j-wut/gp2040-hardware/README.md

# Open Stick Community hardware repo

This repository is a collection of open-source hardware designs which have been submitted to the project.

# Designs

3D Prints

- [3D Printable Stand - Small](/3D%20Prints/3D%20Printable%20Stand/README.md) - Designed by TheTrain
- [3D Printable Stand - Large](/3D%20Prints/3D%20Printable%20Stand/README.md) - Designed by TheTrain
- [3D Printable Fightstick Case](/3D%20Prints/Fightstick%20Case/README.md) - Designed by TheTrain
- [3D Printable Open Stick Mini](/3D%20Prints/Open%20Stick%20Mini/README.md) - Designed by TheTrain
- [3D Printable Fightstick Case XL](/3D%20Prints/Fightstick%20Case/Community%20submissions/3D%20print%20files/Fightstick%20XL/Open%20Stick%20XL%20-%20Main%20Frame%20(x4%20Buttons).stl) - Designed by Lucipher
- [3D Printable Open Stick Modular](/3D%20Prints/Open%20Stick%20Modular%20(OSM)/README.md) - Designed by TheTrain
- [3D Printable Open Stick Modular - Mini](/3D%20Prints/Open%20Stick%20Modular%20-%20Mini%20(OSM-Mini)/README.md) - Designed by TheTrain
- [3D Printable Open Stick Modular - Slim](/3D%20Prints/Open%20Stick%20Modular%20-%20Slim%20(OSM-Slim)/README.md) - Designed by TheTrain
- [3D Printable Open Stick Astro](/3D%20Prints/Open%20Stick%20Astro%20(OSASTRO)/README.md) - Designed by TheTrain
- [3D Printable OSBMX v2 Buttons](/3D%20Prints/OSBMX%20v2/README.md) - Designed by TheTrain
- [3D Printable OSBLP v2 Buttons](/3D%20Prints/OSBLP%20v2/README.md) - Designed by TheTrain
- [3D Printable OSBMX v2 SiTong Edition Buttons](/3D%20Prints/OSBMX%20v2/Community%20submissions/OSBMX%20v2%20-%20SiTong%20Edition/README.md) - Designed by TheTrain (remixed from the OSBLP v2 by TheTrain)
- [3D Printable OSBLP v2 SiTong Edition Buttons](/3D%20Prints/OSBLP%20v2/Community%20submissions/OSBLP%20v2%20-%20SiTong%20Edition/README.md) - Designed by TheTrain (remixed from the OSBLP v2 by TheTrain)
- [3D Printable OSBHE v2 Buttons](/3D%20Prints/OSBHE%20v2/README.md) - Designed by TheTrain
- [3D Printable OSB Plug](/3D%20Prints/OSB%20Plug/README.md) - Designed by TheTrain
- [3D Printable OSB Analog Stick](/3D%20Prints/OSB%20Analog%20Stick/README.md) - Designed by TheTrain
- [Open Source Arcade Stand - OSAS](/3D%20Prints/Open%20Source%20Arcade%20Stand%20(OSAS)/README.md) - Designed by TheTrain

GP2040-CE Official Boards

- [RP2040 Advanced Breakout Board v5.6E with USB Passthrough](/Boards/GP2040-CE%20Official%20Boards/RP2040%20Advanced%20Breakout%20Board/RP2040%20Advanced%20Breakout%20Board%20-%20Passthrough/README.md) - Designed by TheTrain
- [RP2040 Advanced Breakout Board v5.2E (no USB Passthrough)](/Boards/GP2040-CE%20Official%20Boards/RP2040%20Advanced%20Breakout%20Board/RP2040%20Advanced%20Breakout%20Board/README.md) - Designed by TheTrain
- [RP2040 Basic Breakout Board v5.4E with USB Passthrough](/Boards/GP2040-CE%20Official%20Boards/RP2040%20Basic%20Breakout%20Board/RP2040%20Basic%20Breakout%20Board%20-%20Passthrough/README.md) - Designed by TheTrain
- [RP2040 Basic Breakout Board v5.4E (no USB Passthrough)](/Boards/GP2040-CE%20Official%20Boards/RP2040%20Basic%20Breakout%20Board/RP2040%20Basic%20Breakout%20Board/README.md) - Designed by TheTrain
- [RP2040 Mini Breakout Board v7.5E with USB Passthrough](/Boards/GP2040-CE%20Official%20Boards/RP2040%20Mini%20Breakout%20Board/RP2040%20Mini%20Breakout%20Board%20-%20Passthrough/README.md) - Designed by TheTrain
- [RP2040 Mini Breakout Board v7.3E (no USB Passthrough)](/Boards/GP2040-CE%20Official%20Boards/RP2040%20Mini%20Breakout%20Board/RP2040%20Mini%20Breakout%20Board/README.md) - Designed by TheTrain
- [RP2040 Quick Solder Breakout Board v1.0 (no USB Passthrough)](/Boards/GP2040-CE%20Official%20Boards/RP2040%20Quick%20Solder%20Breakout%20Board/README.md) - Designed by TheTrain

GP2040-CE Official Controllers

- [ARC Accessibility Controller](/Boards/GP2040-CE%20Official%20Controllers/ARC%20Accessibility%20Controller/README.md) - Designed by TheTrain
- [Flatbox Rev 5 RGB](/Boards/GP2040-CE%20Official%20Controllers/Flatbox%20Rev%205%20RGB/README.md) - Remixed by TheTrain from the Flatbox Rev 5 by Jfedor
- [Flatbox Rev 5 Passthrough](/Boards/GP2040-CE%20Official%20Controllers/Flatbox%20Rev%205%20Passthrough/README.md) - Remixed by TheTrain from the Flatbox Rev 5 by Jfedor
- [Open_Core0 v2.0](/Boards/GP2040-CE%20Official%20Controllers/Open_Core0/README.md) - Designed by TheTrain
- [Open_Core0 WASD v2.0](/Boards/GP2040-CE%20Official%20Controllers/Open_Core0%20WASD/README.md) - Designed by TheTrain
- [Open_Core0 MIXUP](/Boards/GP2040-CE%20Official%20Controllers/Open_Core0%20MIXUP/README.md) - Designed by TheTrain
- [Zero_Rhythm v1.0](/Boards/GP2040-CE%20Official%20Controllers/Zero%20Rhythm/README.md) - Designed by TheTrain
- [Pocket Pad](/Boards/GP2040-CE%20Official%20Controllers/Pocket%20Pad/README.md) - Designed by TheTrain
- [Pocket Pad WASD](/Boards/GP2040-CE%20Official%20Controllers/Pocket%20Pad%20WASD/README.md) - Designed by TheTrain
- [Mini Pad](/Boards/GP2040-CE%20Official%20Controllers/Mini%20Pad/README.md) - Designed by TheTrain

Retail Stick Replacement Boards

- [Hori Fighting Edge PS3 (FE PS3)](/Boards/Retail%20Stick%20Replacement%20Boards/Hori%20Fighting%20Edge%20PS3%20(FE%20PS3)/README.md) - Designed by TheTrain
- [Hori Fighting Edge PS4 (FE PS4)](/Boards/Retail%20Stick%20Replacement%20Boards/Hori%20Fighting%20Edge%20PS4%20(FE%20PS4)/README.md) - Designed by TheTrain
- [Hori Real Arcade Pro N PS4 (RAP N PS4)](/Boards/Retail%20Stick%20Replacement%20Boards/Hori%20Real%20Arcade%20Pro%20N%20PS4%20(RAP%20N%20PS4)/README.md) - Designed by TheTrain
- [Hori Real Arcade Pro VLX PS3 (RAP VLX PS3)](/Boards/Retail%20Stick%20Replacement%20Boards/Hori%20Real%20Arcade%20Pro%20VLX%20PS3%20(RAP%20VLX%20PS3)/README.md) - Designed by TheTrain
- [SEGA Dreamcast Twin Stick (with USB Passthrough)](/Boards/Retail%20Stick%20Replacement%20Boards/SEGA%20Dreamcast%20Twin%20Stick%20(with%20USB%20Passthrough)/README.md) - Designed by indigotrance

Supported Boards

- [Ghost Auth v2.0](/Boards/Supported%20Boards/Ghost%20Auth/README.md) - Designed by TheTrain
- [GP2040 Keyboard converter](/Boards/Supported%20Boards/GP2040%20Keyboard%20Converter/Waveshare%20Zero-PCB/README.md) - Designed by Infraredaces
- [USB Pasthrough Add-on Board](/Boards/Supported%20Boards/USB%20Passthrough%20Board/README.md) - Designed by TheTrain
- [Tiny USB Hub v1.2 - 2x USB with USB C](/Boards/Supported%20Boards/USB%20Hubs/Tiny%20USB%20Hub%20v1.2e/README.md) - Designed by TheTrain
- [Tiny USB Hub v1.3 - 2x USB Direct Connect](/Boards/Supported%20Boards/USB%20Hubs/Tiny%20USB%20Hub%20v1.3e/README.md) - Designed by TheTrain
- [Tiny USB Hub v1.3 v2 - 2x USB Direct Connect](/Boards/Supported%20Boards/USB%20Hubs/Tiny%20USB%20Hub%20v1.3e%20v2/README.md) - Designed by TheTrain
- [Tiny USB Hub v1.4 - 4x USB Direct Connect](/Boards/Supported%20Boards/USB%20Hubs/Tiny%20USB%20Hub%20v1.4e/README.md) - Designed by TheTrain
- [HE Breakout Board v1.1](/Boards/Supported%20Boards/HE%20Breakout%20Board/README.md) - Designed by TheTrain
- [RPBoy v1.0](/Boards/Supported%20Boards/RPBoy/README.md) - Designed by TheTrain
- [RPBoy Mini v2.0](/Boards/Supported%20Boards/RPBoy%20Mini/README.md) - Designed by TheTrain
- [Key Matrix Diode Adapter](/Boards/Supported%20Boards/Key%20Matrix%20Diode%20Adapter/README.md) - 44-switch keyboard-style matrix with N-key rollover for the RP2040 Advanced Breakout Board (USB Passthrough)

Miscellaneous

- [Haute42/COSMOX Bottom Foam](/Miscellaneous/Haute42%20COSMOX%20Bottom%20Foam/README.md) - Designed by TheTrain
- [Sanjuks V3 AM5 Adapter Plate](/Miscellaneous/Sanjuks%20V3%20AM5%20Adapter%20Plate/README.md) - Designed by TheTrain
- [Sanjuks Style Nobi Topper](/Miscellaneous/Sanjuks%20Style%20Nobi%20Topper/README.md) - Designed by TheTrain
- [Open LED Project - Sanwa 30mm RGB LEDs](/Miscellaneous/Open%20LED%20Project%20-%20Sanwa%2030mm%20RGB%20LED/README.md) - Designed by TheTrain
- [Open LED Project - Addressable RGB LED Light Bar](/Miscellaneous/Open%20LED%20Project%20-%20Addressable%20RGB%20LED%20Light%20Bar/README.md) - Designed by TheTrain
- [Nintendo Switch Art Cart](/Miscellaneous/Nintendo%20Switch%20Art%20Carts/README.md) - Designed by TheTrain, art template by TheTrain
- [Sanwa JLF Plate Cover](/Miscellaneous/Sanwa%20JLF%20Plate%20Cover/README.md) - Designed by TheTrain

Trains Vewlix Stuff

- [Vewlix Coin Return Adapter](/Trains%20Vewlix%20Stuff/Vewlix%20Coin%20Return%20Adapter/README.md) - Designed by TheTrain
- [Vewlix Coin Return Slot](/Trains%20Vewlix%20Stuff/Vewlix%20Coin%20Return%20Slot/README.md) - Designed by TheTrain
- [Vewlix Coin Mech](/Trains%20Vewlix%20Stuff/Vewlix%20Coin%20Mech/README.md) - Designed by TheTrain
- [Vewlix Stickers](/Trains%20Vewlix%20Stuff/Vewlix%20Stickers/README.md) - Remixes and customs by TheTrain
- [Vewlix Control Panel SiTong Adapter Rings](/Trains%20Vewlix%20Stuff/Vewlix%20Control%20Panel%20SiTong%20Adapter%20Rings/README.md) - Designed by TheTrain
- [Vewlix NESiCA NFC Reader](/Trains%20Vewlix%20Stuff/Vewlix%20NESiCA%20NFC%20Reader/README.md) - Designed by TheTrain
- [Vewlix Sub-Panel Art and Cut Files](/Trains%20Vewlix%20Stuff/Vewlix%20Sub-Panel%20Art%20and%20Cut%20Files/README.md) - Designed by Jermaine Davis

Trains Sim Racing Stuff

- [Logitech G PRO RS Wheel Hub wall mount](/Trains%20Sim%20Racing%20Stuff/Logitech%20G%20PRO%20RS%20Wheel%20Hub%20wall%20mount/README.md) - Designed by TheTrain
- [Logitech G PRO RS Wheel Hub 4040 mount](/Trains%20Sim%20Racing%20Stuff/Logitech%20G%20PRO%20RS%20Wheel%20Hub%204040%20mount/README.md) - Designed by TheTrain
- [Logitech G PRO RS Wheel Hub Shifter Pad Mod](/Trains%20Sim%20Racing%20Stuff/Logitech%20RS%20Wheel%20Hub%20Shifter%20Pad%20Mod/README.md) - Designed by TheTrain
- [Logitech G PRO RS Wheel Rim template](/Trains%20Sim%20Racing%20Stuff/Logitech%20G%20PRO%20RS%20Wheel%20Rim%20template/README.md) - Designed by TheTrain
- [Wind Sim](/Trains%20Sim%20Racing%20Stuff/Wind%20Sim/README.md) - Designed by TheTrain
- [LapTimer](/Trains%20Sim%20Racing%20Stuff/Laptimer/README.md) - Designed by TheTrain
- [Porsche GT3 R Plate](/Trains%20Sim%20Racing%20Stuff/Porsche%20911%20GT3%20R%20plate/README.md) - Designed by TheTrain

Trains Theatrhythm Stuff
- [Theatrhythm - All-Star Carnival Manual](/Trains%20Theatrhythm%20Stuff/Theatrhythm%20Manual/Theatrhythm%20-%20All-Star%20Carnival%20-%20Manual.pdf)
- [Theatrhythm - All-Star Carnival JLF Shaft](/Trains%20Theatrhythm%20Stuff/Theatrhythm%20JLF%20shaft/README.md) - Designed by LayerShift
- [Theatrhythm - All-Star Carnival Side Plexi Art](/Trains%20Theatrhythm%20Stuff/Theatrhythm%20ASC%20Arcade%20Cabinet%20Art/Theatrhythm%20ASC%20Side%20Plexi%20Art/README.md) - Designed by TheTrain
- [Theatrhythm - All-Star Carnival Front Control Panel Art](/Trains%20Theatrhythm%20Stuff/Theatrhythm%20ASC%20Arcade%20Cabinet%20Art/Theatrhythm%20ASC%20Front%20Control%20Panel%20Art/README.md) - Designed by TheTrain
- [Theatrhythm - All-Star Carnival NESiCA Reader Art](/Trains%20Theatrhythm%20Stuff/Theatrhythm%20ASC%20Arcade%20Cabinet%20Art/Theatrhythm%20ASC%20NESiCA%20Reader%20Art/README.md) - Designed by TheTrain
- [Theatrhythm - All-Star Carnival Coin Sticker Art](/Trains%20Theatrhythm%20Stuff/Theatrhythm%20ASC%20Arcade%20Cabinet%20Art/Theatrhythm%20ASC%20Coin%20Sticker%20Art/README.md) - Designed by TheTrain

Trains Arcade Machine Manual Stuff

- [Taito Vewlix L - Manual - Part 1](/Trains%20Vewlix%20Stuff/Vewlix%20Manual/Taito%20Vewlix%20L%20-%20Manual%20-%20Part%201.pdf)
- [Taito Vewlix L - Manual - Part 2](/Trains%20Vewlix%20Stuff/Vewlix%20Manual/Taito%20Vewlix%20L%20-%20Manual%20-%20Part%202.pdf)
- [Taito Vewlix L - Manual - Part 3](/Trains%20Vewlix%20Stuff/Vewlix%20Manual/Taito%20Vewlix%20L%20-%20Manual%20-%20Part%203.pdf)
- [Theatrhythm - All-Star Carnival](/Trains%20Theatrhythm%20Stuff/Theatrhythm%20Manual/Theatrhythm%20-%20All-Star%20Carnival%20-%20Manual.pdf)

Tutorials

- [Focus Attack RGB LED Board Configuration](/Tutorials/Focus%20Attack%20LED%20Board%20Configuration/README.md) for the [RP2040 Advanced Breakout Board v5.6](/Boards/GP2040-CE%20Official%20Boards/RP2040%20Advanced%20Breakout%20Board/RP2040%20Advanced%20Breakout%20Board%20-%20Passthrough/README.md) - Written by TheTrain
- [USB Passthrough Add-on Board Installation](/Tutorials/USB%20Passthrough%20Board%20Installation/README.md) - Written by TheTrain
- [Logitech RS Wheel Hub Shifter Pad Mod](/Tutorials/Logitech%20RS%20Wheel%20Hub%20Shifter%20Pad%20Mod/README.md) - Written by TheTrain

Vendor Resources

- [GP2040-CE Logo Files](/Vendor%20Resources/GP2040-CE%20Logo%20files/README.md)

# Contributing

Any design submitted to this repository must be submitted by the original copyright holder and include a [license](#licensing). If your license requires attribution, you must provide details on how to appropriately attribute the design.

# Copyright

All copyrights are retained by the original author(s) unless the copyright is explicitly transferred to the Open Stick Community.

# Licensing

Check the LICENSE of each design for details on how the design can be used.
