j-wut/gp2040-hardware/Boards/Supported Boards/Key Matrix Diode Adapter/sim-results.txt

Adapter PCB copper per net: rows 29.5-37.1 pF, columns 31.4-50.1 pF
Timing: settle 5 us, row delay 50 us -> full scan about 224 us (USB reports every 1000 us)
Pass = pressed reads < 0.8 V and open reads > 2.0 V on all 44 switches, every pattern

wiring (ribbon / switch wire / column chain)   pull-up press seen  recovery worst pressed worst open  result
no wiring (pins only)                             50k      90 ns    3.4 us       0.482 V    3.300 V  PASS
no wiring (pins only)                             80k      89 ns    5.5 us       0.451 V    3.298 V  PASS
short: bench test (0.15 / 0.2 / 1 m)              50k     190 ns    6.4 us       0.482 V    3.295 V  PASS
short: bench test (0.15 / 0.2 / 1 m)              80k     189 ns   10.4 us       0.451 V    3.248 V  PASS
typical: arcade stick (0.3 / 0.5 / 3 m)           50k     338 ns   11.7 us       0.482 V    3.220 V  PASS
typical: arcade stick (0.3 / 0.5 / 3 m)           80k     337 ns   19.0 us       0.451 V    2.996 V  PASS
long: cabinet (1 / 1 / 6 m)                       50k     568 ns   20.8 us       0.482 V    2.930 V  PASS
long: cabinet (1 / 1 / 6 m)                       80k     567 ns   33.8 us       0.453 V    2.502 V  PASS

press seen: time from the row going low until a pressed column reads low at the RP2040 pin
recovery:   time after a row is released until its columns read high again (row delay must cover it)
