j-wut/gp2040-hardware/Boards/Supported Boards/Key Matrix Diode Adapter/fab/keymatrix-adapter-schematic.pdf

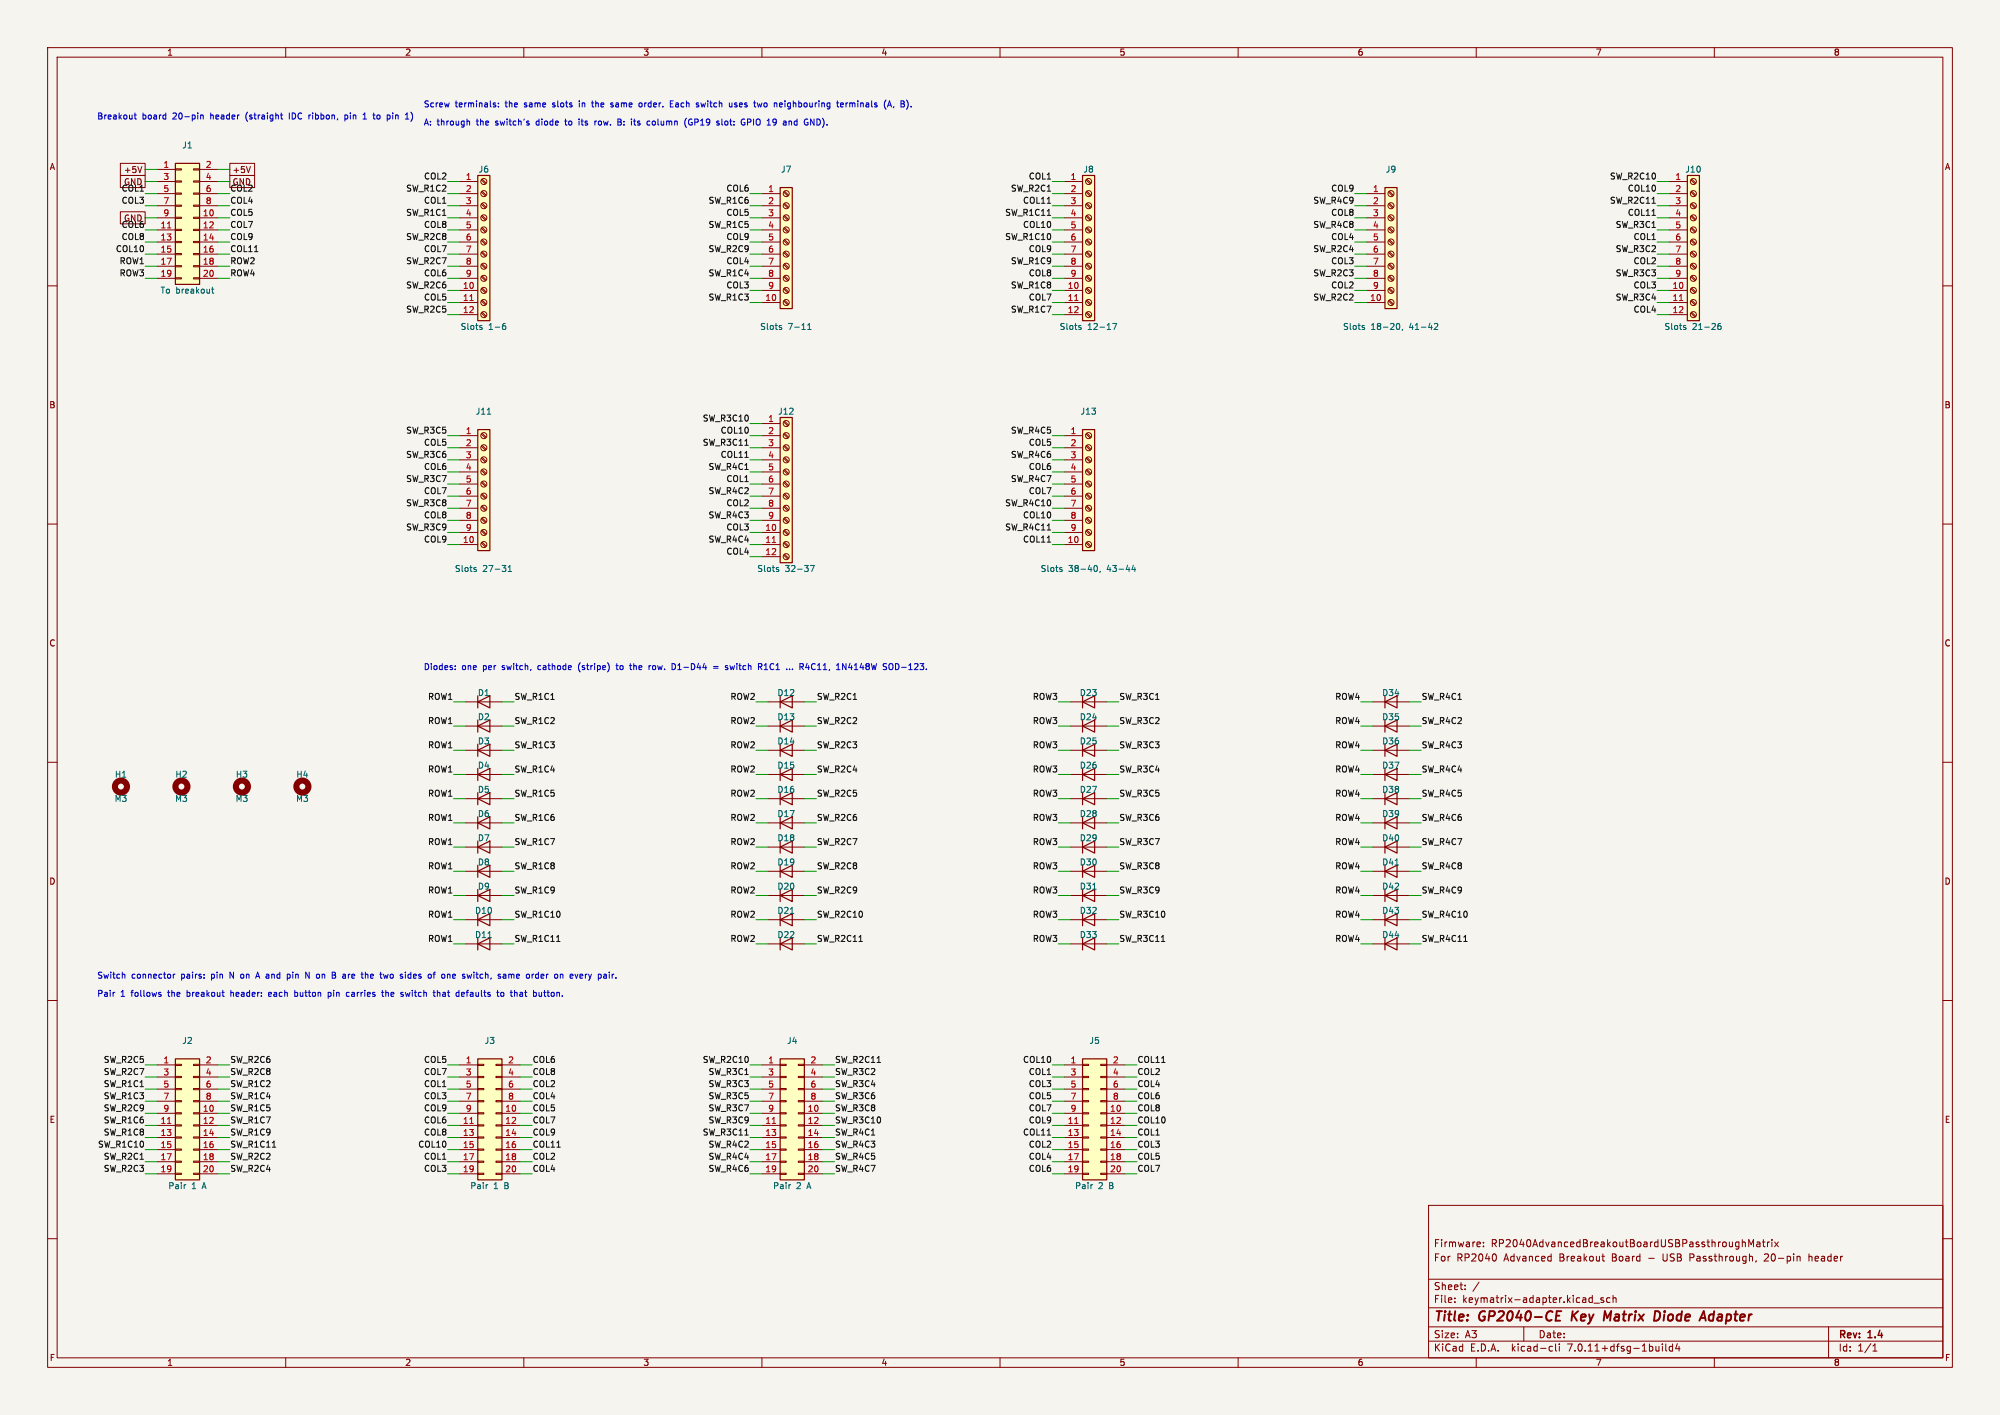
[picture p1: page 1]
