j-wut/gp2040-hardware/Boards/Supported Boards/Key Matrix Diode Adapter/keymatrix-adapter.kicad_pcb

## KiCad design Boards/Supported Boards/Key Matrix Diode Adapter/keymatrix-adapter.kicad_pcb (2026-11-04)

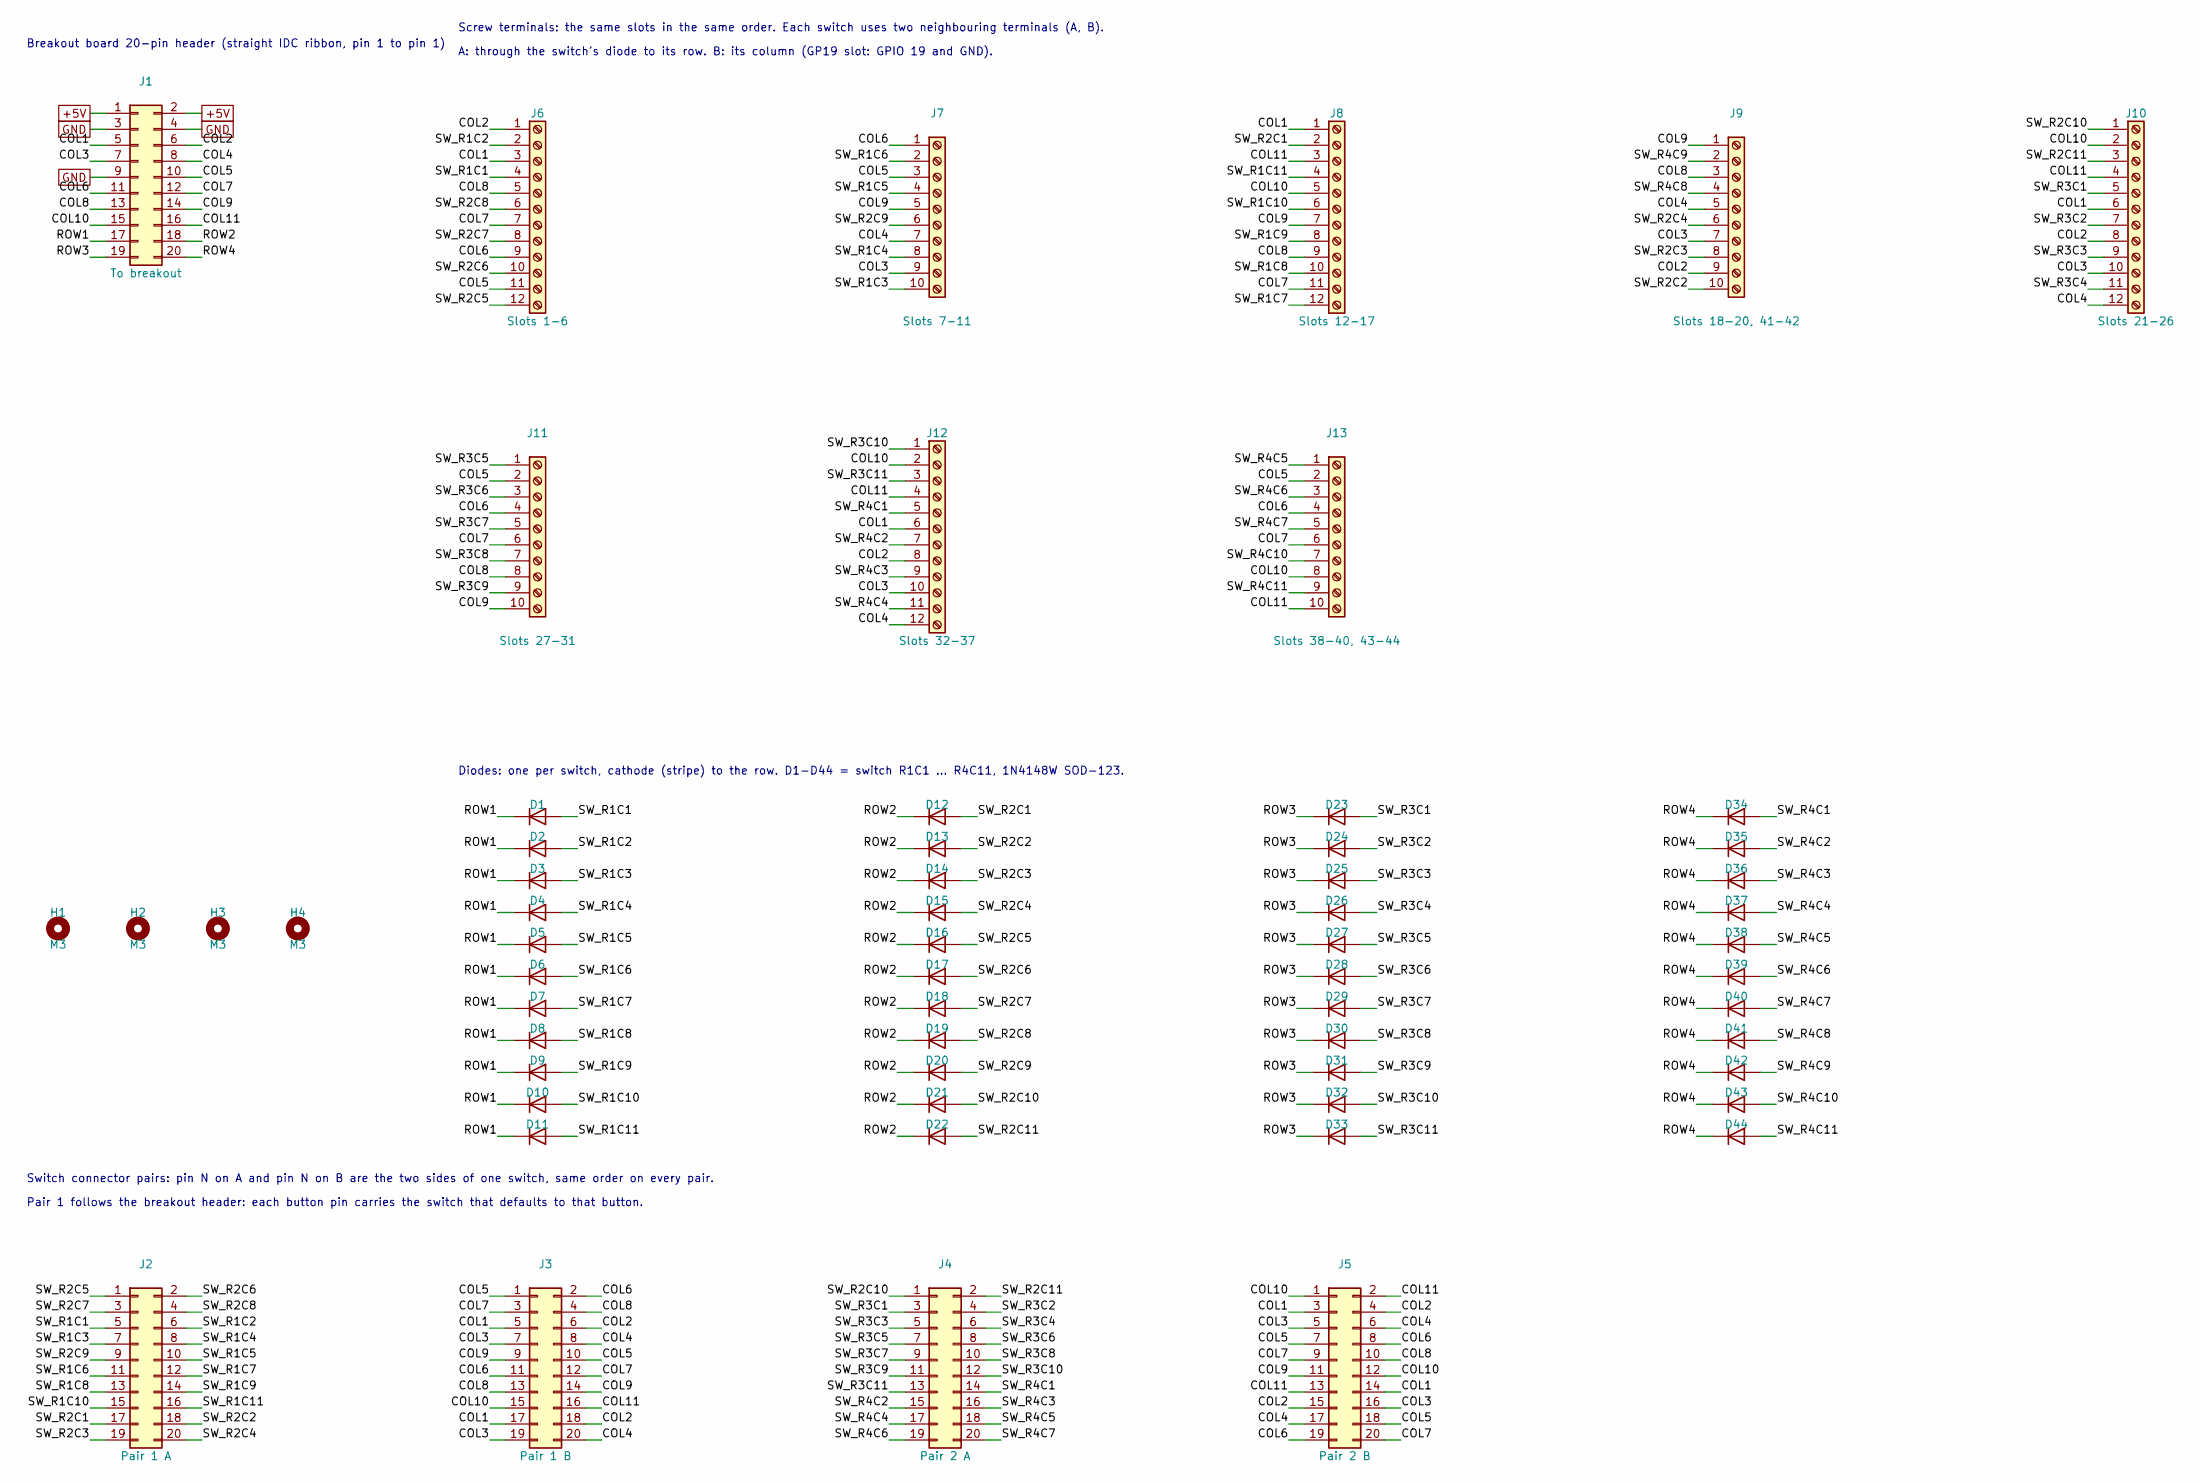
[picture p2: schematic keymatrix-adapter.kicad_sch, GP2040-CE Key Matrix Diode Adapter]

Parts:
D1, D2, D3, D4, D5, D6, D7, D8, D9, D10, D11, D12, D13, D14, D15, D16, D17, D18, D19, D20, D21, D22, D23, D24, D25, D26, D27, D28, D29, D30, D31, D32, D33, D34, D35, D36, D37, D38, D39, D40, D41, D42, D43, D44: 1N4148W; D_SOD-123
H1, H2, H3, H4: M3; MountingHole_3.2mm_M3
J1: To breakout; IDC-Header_2x10_P2.54mm_Vertical
J2: Pair 1 A; IDC-Header_2x10_P2.54mm_Vertical
J3: Pair 1 B; IDC-Header_2x10_P2.54mm_Vertical
J4: Pair 2 A; IDC-Header_2x10_P2.54mm_Vertical
J5: Pair 2 B; IDC-Header_2x10_P2.54mm_Vertical
J6: Slots 1-6; TerminalBlock_Phoenix_PT-1,5-12-3.5-H_1x12_P3.50mm_Horizont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
J7: Slots 7-11; TerminalBlock_Phoenix_PT-1,5-10-3.5-H_1x10_P3.50mm_Horizont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
J8: Slots 12-17; TerminalBlock_Phoenix_PT-1,5-12-3.5-H_1x12_P3.50mm_Horizont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
J9: Slots 18-20, 41-42; TerminalBlock_Phoenix_PT-1,5-10-3.5-H_1x10_P3.50mm_Horizont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
J10: Slots 21-26; TerminalBlock_Phoenix_PT-1,5-12-3.5-H_1x12_P3.50mm_Horizont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
J11: Slots 27-31; TerminalBlock_Phoenix_PT-1,5-10-3.5-H_1x10_P3.50mm_Horizont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
J12: Slots 32-37; TerminalBlock_Phoenix_PT-1,5-12-3.5-H_1x12_P3.50mm_Horizont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
J13: Slots 38-40, 43-44; TerminalBlock_Phoenix_PT-1,5-10-3.5-H_1x10_P3.50mm_Horizont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

Connections:
+5V: J1.1, J1.2
COL1: J1.5, J3.5, J3.17, J5.3, J5.14, J6.3, J8.1, J10.6, J12.6
COL2: J1.6, J3.6, J3.18, J5.4, J5.15, J6.1, J9.9, J10.8, J12.8
COL3: J1.7, J3.7, J3.19, J5.5, J5.16, J7.9, J9.7, J10.10, J12.10
COL4: J1.8, J3.8, J3.20, J5.6, J5.17, J7.7, J9.5, J10.12, J12.12
COL5: J1.10, J3.1, J3.10, J5.7, J5.18, J6.11, J7.3, J11.2, J13.2
COL6: J1.11, J3.2, J3.11, J5.8, J5.19, J6.9, J7.1, J11.4, J13.4
COL7: J1.12, J3.3, J3.12, J5.9, J5.20, J6.7, J8.11, J11.6, J13.6
COL8: J1.13, J3.4, J3.13, J5.10, J6.5, J8.9, J9.3, J11.8
COL9: J1.14, J3.9, J3.14, J5.11, J7.5, J8.7, J9.1, J11.10
COL10: J1.15, J3.15, J5.1, J5.12, J8.5, J10.2, J12.2, J13.8
COL11: J1.16, J3.16, J5.2, J5.13, J8.3, J10.4, J12.4, J13.10
GND: J1.3, J1.4, J1.9
ROW1: D1.1 (K), D2.1 (K), D3.1 (K), D4.1 (K), D5.1 (K), D6.1 (K), D7.1 (K), D8.1 (K), D9.1 (K), D10.1 (K), D11.1 (K), J1.17
ROW2: D12.1 (K), D13.1 (K), D14.1 (K), D15.1 (K), D16.1 (K), D17.1 (K), D18.1 (K), D19.1 (K), D20.1 (K), D21.1 (K), D22.1 (K), J1.18
ROW3: D23.1 (K), D24.1 (K), D25.1 (K), D26.1 (K), D27.1 (K), D28.1 (K), D29.1 (K), D30.1 (K), D31.1 (K), D32.1 (K), D33.1 (K), J1.19
ROW4: D34.1 (K), D35.1 (K), D36.1 (K), D37.1 (K), D38.1 (K), D39.1 (K), D40.1 (K), D41.1 (K), D42.1 (K), D43.1 (K), D44.1 (K), J1.20
SW_R1C1: D1.2 (A), J2.5, J6.4
SW_R1C2: D2.2 (A), J2.6, J6.2
SW_R1C3: D3.2 (A), J2.7, J7.10
SW_R1C4: D4.2 (A), J2.8, J7.8
SW_R1C5: D5.2 (A), J2.10, J7.4
SW_R1C6: D6.2 (A), J2.11, J7.2
SW_R1C7: D7.2 (A), J2.12, J8.12
SW_R1C8: D8.2 (A), J2.13, J8.10
SW_R1C9: D9.2 (A), J2.14, J8.8
SW_R1C10: D10.2 (A), J2.15, J8.6
SW_R1C11: D11.2 (A), J2.16, J8.4
SW_R2C1: D12.2 (A), J2.17, J8.2
SW_R2C2: D13.2 (A), J2.18, J9.10
SW_R2C3: D14.2 (A), J2.19, J9.8
SW_R2C4: D15.2 (A), J2.20, J9.6
SW_R2C5: D16.2 (A), J2.1, J6.12
SW_R2C6: D17.2 (A), J2.2, J6.10
SW_R2C7: D18.2 (A), J2.3, J6.8
SW_R2C8: D19.2 (A), J2.4, J6.6
SW_R2C9: D20.2 (A), J2.9, J7.6
SW_R2C10: D21.2 (A), J4.1, J10.1
SW_R2C11: D22.2 (A), J4.2, J10.3
SW_R3C1: D23.2 (A), J4.3, J10.5
SW_R3C2: D24.2 (A), J4.4, J10.7
SW_R3C3: D25.2 (A), J4.5, J10.9
SW_R3C4: D26.2 (A), J4.6, J10.11
SW_R3C5: D27.2 (A), J4.7, J11.1
SW_R3C6: D28.2 (A), J4.8, J11.3
SW_R3C7: D29.2 (A), J4.9, J11.5
SW_R3C8: D30.2 (A), J4.10, J11.7
SW_R3C9: D31.2 (A), J4.11, J11.9
SW_R3C10: D32.2 (A), J4.12, J12.1
SW_R3C11: D33.2 (A), J4.13, J12.3
SW_R4C1: D34.2 (A), J4.14, J12.5
SW_R4C2: D35.2 (A), J4.15, J12.7
SW_R4C3: D36.2 (A), J4.16, J12.9
SW_R4C4: D37.2 (A), J4.17, J12.11
SW_R4C5: D38.2 (A), J4.18, J13.1
SW_R4C6: D39.2 (A), J4.19, J13.3
SW_R4C7: D40.2 (A), J4.20, J13.5
SW_R4C8: D41.2 (A), J9.4
SW_R4C9: D42.2 (A), J9.2
SW_R4C10: D43.2 (A), J13.7
SW_R4C11: D44.2 (A), J13.9

Notes on the sheet:
Breakout board 20-pin header (straight IDC ribbon, pin 1 to pin 1)
Switch connector pairs: pin N on A and pin N on B are the two sides of one switch, same order on every pair.
Pair 1 follows the breakout header: each button pin carries the switch that defaults to that button.
Screw terminals: the same slots in the same order. Each switch uses two neighbouring terminals (A, B).
A: through the switch's diode to its row. B: its column (GP19 slot: GPIO 19 and GND).
Diodes: one per switch, cathode (stripe) to the row. D1-D44 = switch R1C1 ... R4C11, 1N4148W SOD-123.

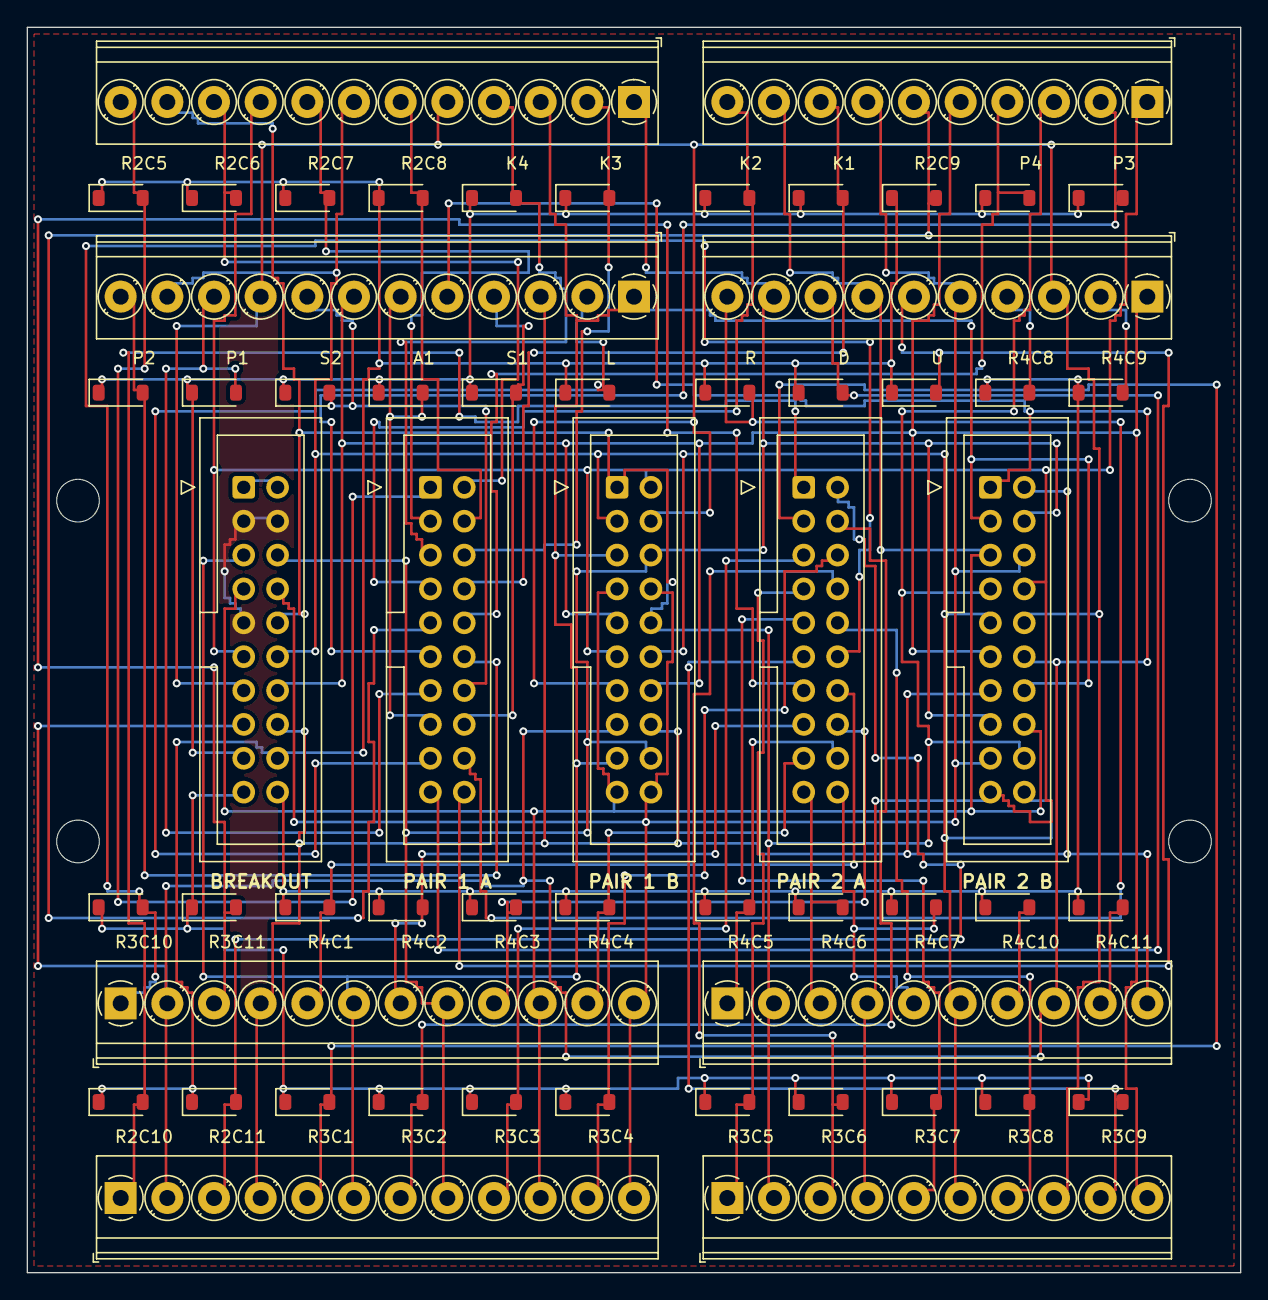
[picture p3: board keymatrix-adapter.kicad_pcb from above]

Board: 2 copper layers, 91.0 x 93.4 mm, 61 parts (0 on the bottom side), 61 nets.
