j-wut/gp2040-hardware/(commit log)

2026-11-04 Add key matrix diode adapter for the RP2040 Advanced Breakout Board (passthrough)
    A 44-switch (4x11) row/column matrix with one diode per switch for full
    N-key rollover, plugging into the breakout board's 20-pin header. Two pairs
    of 20-pin switch connectors (pair 1 in the breakout's pin order) plus screw
    terminals for every switch. KiCad 7 project generated from one table, with
    DRC, netlist, header-pinout and ordering checks and an ngspice simulation.
    Moved from the GP2040-CE firmware branch. J1's pin numbers now follow the
    breakout board's own design file (pins 1/2 are +5 V, pin 20 is UP); the
    earlier copy had them reversed.
    [keymatrix-adapter-B_Cu.gbl, keymatrix-adapter-B_Mask.gbs, keymatrix-adapter-B_Paste.gbp, keymatrix-adapter-B_Silkscreen.gbo, keymatrix-adapter-Edge_Cuts.gm1, keymatrix-adapter-F_Cu.gtl, keymatrix-adapter-F_Mask.gts, keymatrix-adapter-F_Paste.gtp]
2026-11-04 Compact the key matrix adapter to 103 x 101.6 mm
    Screw terminals now run around all four edges: pair 1 along the top and
    down the right side, pair 2 along the bottom and down the left side, with
    two terminal-only switches at the lower end of each side. Eight 10- and
    12-way blocks replace the nine 10- and 8-way blocks. Tracks are 0.2 mm on
    a 0.4 mm routing grid with 0.6 mm vias so the smaller board still routes.
    Mounting holes move to the corners. Simulation re-run on the new copper.
    [keymatrix-adapter-B_Cu.gbl, keymatrix-adapter-B_Mask.gbs, keymatrix-adapter-B_Paste.gbp, keymatrix-adapter-B_Silkscreen.gbo, keymatrix-adapter-Edge_Cuts.gm1, keymatrix-adapter-F_Cu.gtl, keymatrix-adapter-F_Mask.gts, keymatrix-adapter-F_Paste.gtp]
2026-11-04 Stack the adapter's screw terminals in rows: 85 x 93.4 mm
    The terminals now stand in four rows, front to back: two above the
    headers with their wire entry toward the top edge (pair 1) and two below
    toward the bottom edge (pair 2). The front row of each pair holds pins
    1-11; the row behind holds pins 12-20 and two terminal-only switches.
    Each row's slot labels and diodes sit just behind it, 6 mm before the
    next row. Terminal pads are 2.0 mm so two tracks fit between pins. The
    long notes come off the silkscreen; the README has them.
    [keymatrix-adapter-B_Cu.gbl, keymatrix-adapter-B_Mask.gbs, keymatrix-adapter-B_Paste.gbp, keymatrix-adapter-B_Silkscreen.gbo, keymatrix-adapter-Edge_Cuts.gm1, keymatrix-adapter-F_Cu.gtl, keymatrix-adapter-F_Mask.gts, keymatrix-adapter-F_Paste.gtp]
2026-11-04 Keep the stock 2.4 mm terminal pads: 91 x 93.4 mm
    The terminal pads go back to the library's 2.4 mm. To route with them, the
    two blocks in each row are 7 mm apart (pad to pad) to leave a channel, and
    the board is 6 mm wider. The router gets 12 attempts.
    [keymatrix-adapter-B_Cu.gbl, keymatrix-adapter-B_Mask.gbs, keymatrix-adapter-B_Paste.gbp, keymatrix-adapter-B_Silkscreen.gbo, keymatrix-adapter-Edge_Cuts.gm1, keymatrix-adapter-F_Cu.gtl, keymatrix-adapter-F_Mask.gts, keymatrix-adapter-F_Paste.gtp]
2026-11-05 Add a trace replay mode to the adapter simulation
    simulate.py --trace trace.json takes a GPIO timeline recorded from the
    firmware's scan loop (row drive/release events and read times, plus held
    switches, wiring and pull-up) and reports every column's voltage and logic
    level at each read. The netlist builder now takes row low intervals, so the
    fixed-schedule run and the replay share one model. The default run's
    results are unchanged.
    [simulate.py]
